ronnythomas/HB-UNI-SenAct-8-8-Hutschiene/README.md

# HB-UNI-SenAct-8-8-Hutschine
## 8x 6A Schaltkontakte + 8 Eingänge 
## Spannungsversorgung 9-36V mit Internen Netzteil oder 5V

## benötigte Hardware
**Vorschlag Bauteile**
* 1x Arduino Pro Mini **ATmega328P (3.3V/8MHz)**
* 1x CC1101 Funkmodul **(868 MHz)**
* 1x FTDI Adapter (wird nur zum Flashen benötigt)

Meine Verwendetet Teile:[Reichelt](https://www.reichelt.de/my/1537601)  

[Hinweise aus HM Forum](https://homematic-forum.de/forum/viewtopic.php?f=76&t=55610&p=671826#p671826)
[Hinweise aus HM Forum](https://homematic-forum.de/forum/viewtopic.php?f=76&t=67728)

[Kontakt via Facebook](https://www.facebook.com/ronny.thomas.83)

[Software](/Sketch)

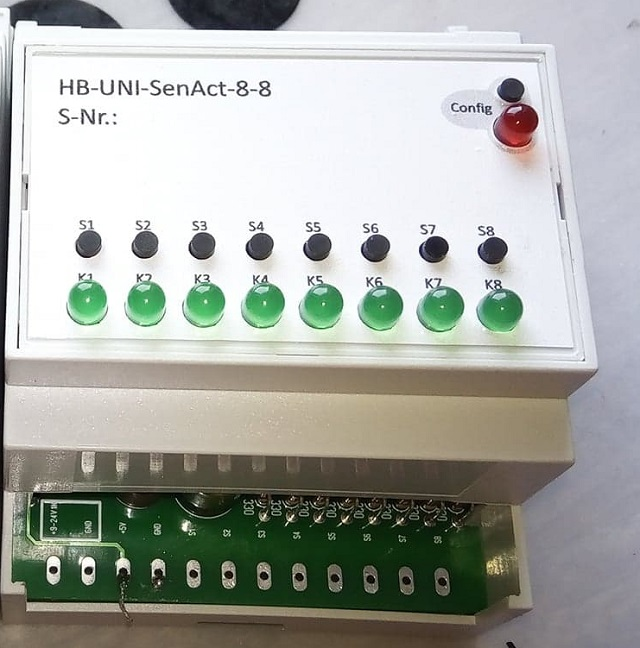
[picture p1: Images/1.jpg]

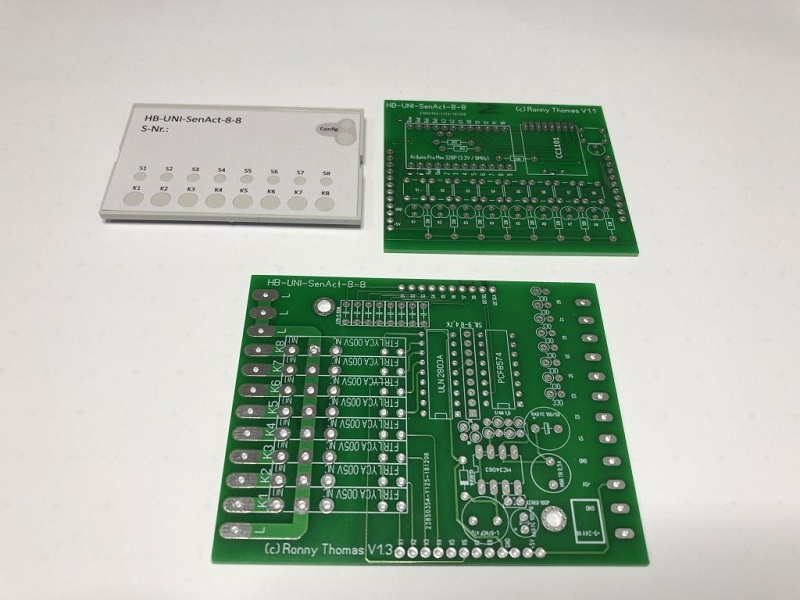
[picture p2: Images/2.JPG]


Controller-Platine:
Auf der oberen Platine zuerst die Widerstände bestücken. Danach die Stiftleisten für die Module einlöten.
Passend dazu die beiden Module einlöten (hierzu können die oberen Stiftleisten ein wenig gekürzt werden)
Dann die Taster einlöten, hierzu sollte man erst bei allen nur ein Pin anlöten und dann komplett ausrichten – es ist wichtig, das alle Taster gerade und in einer Linie fixiert werden !
Genauso verfahren wir mit den 5mm LED’s diese sollten auch erst mit einen Pin angelötet werden und dann ausgerichtet werden.
Die Antenne ist aber nicht zu vergessen, die durch die Platine „gefädelt“ wird und am Empfangsmodul mittig eingelötet wird. Dazu sind passende Bohrungen auf dem Board vorhanden.

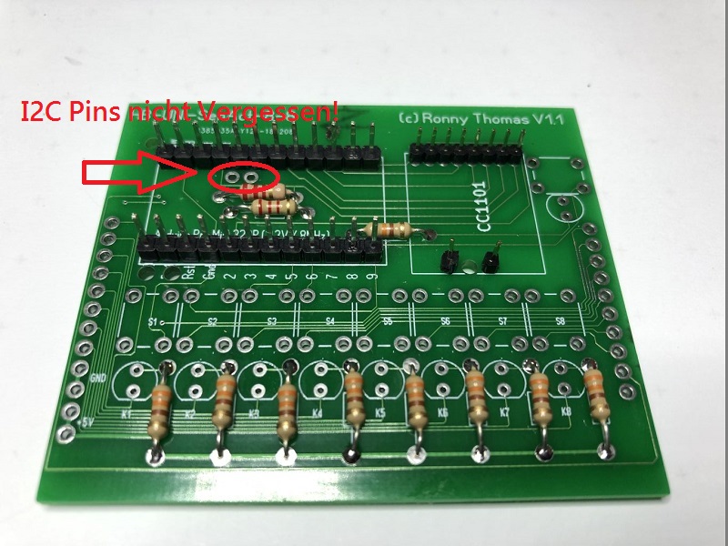
[picture p3: Images/3.JPG]

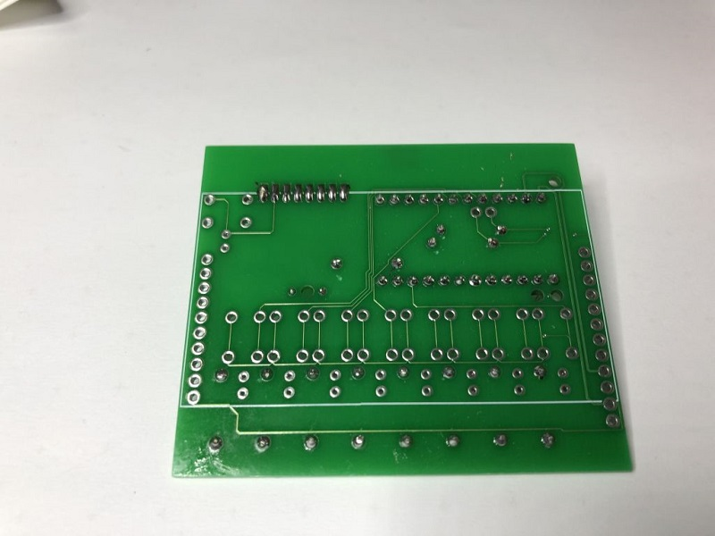
[picture p4: Images/4.JPG]

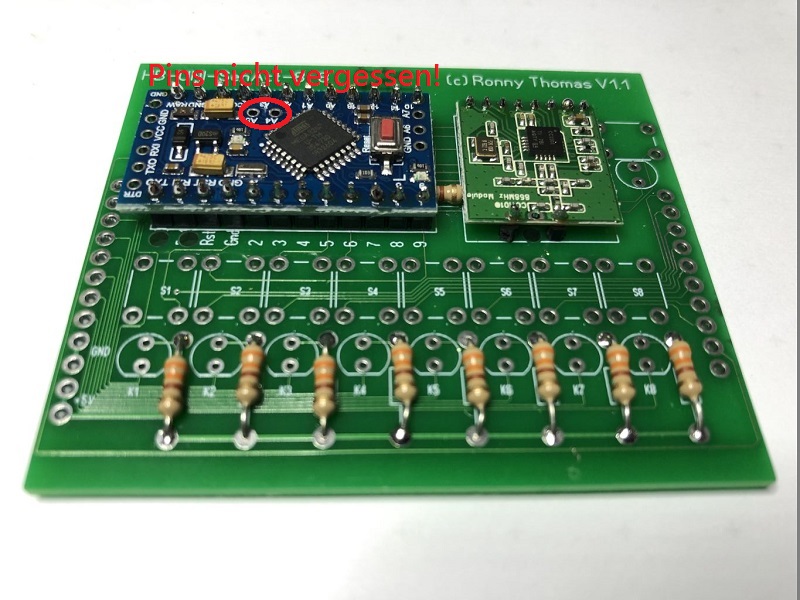
[picture p5: Images/5.JPG]

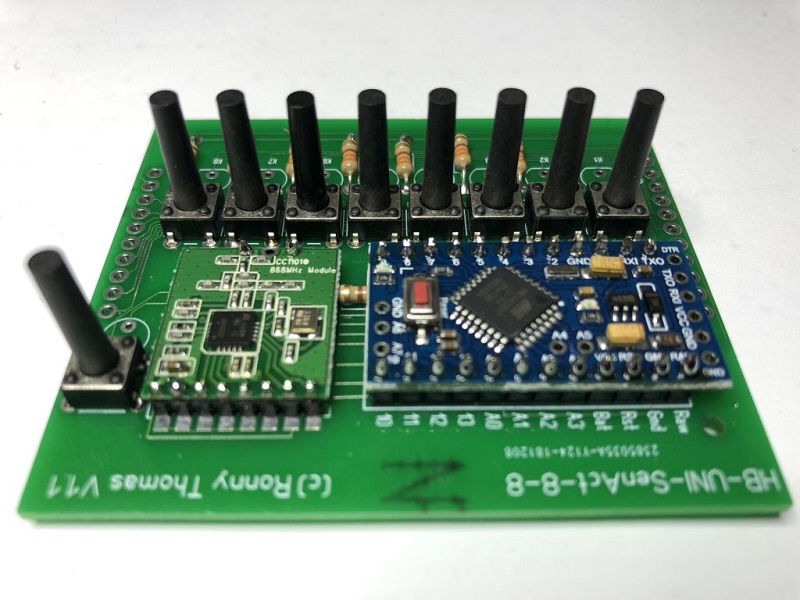
[picture p6: Images/6.JPG]

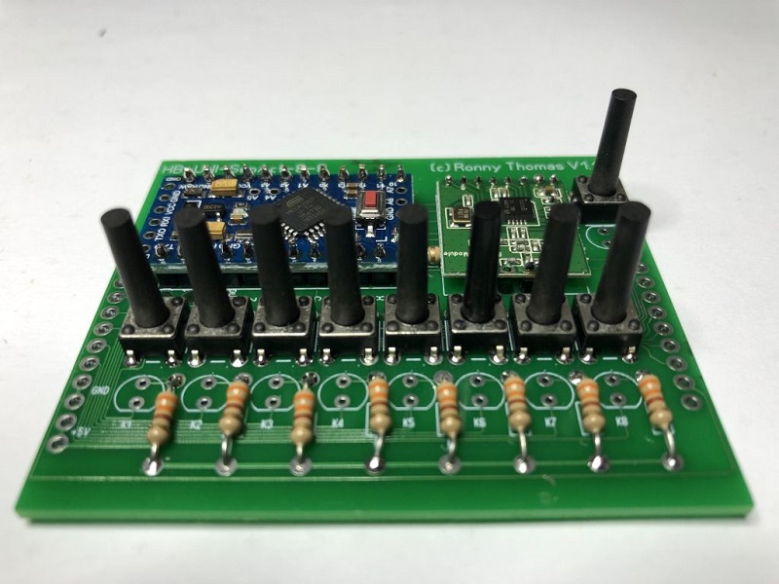
[picture p7: Images/7.JPG]

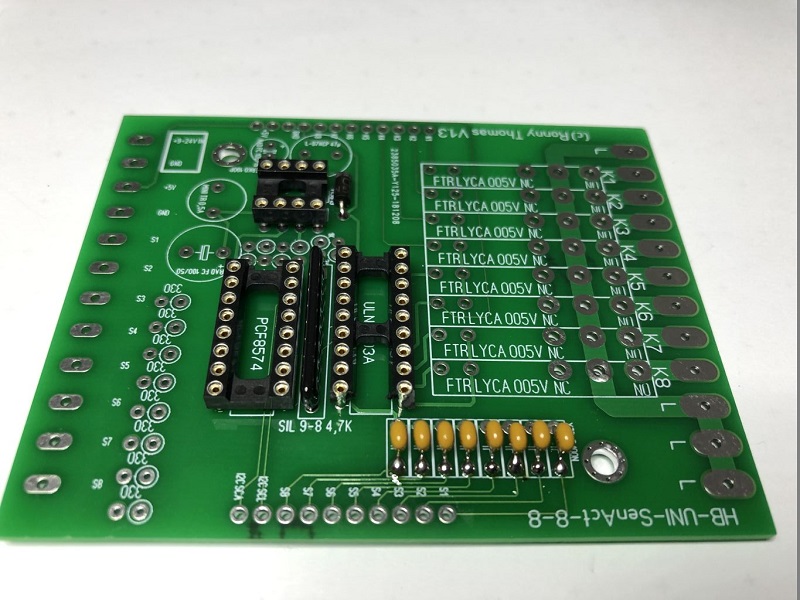
[picture p8: Images/8.JPG]

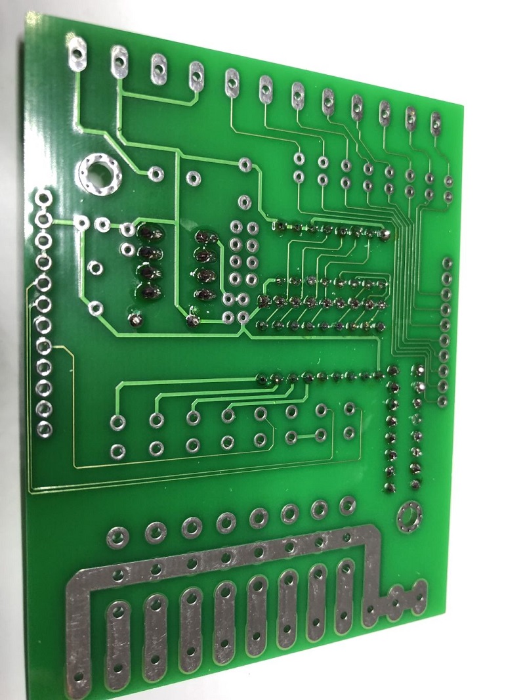
[picture p9: Images/9.JPG]

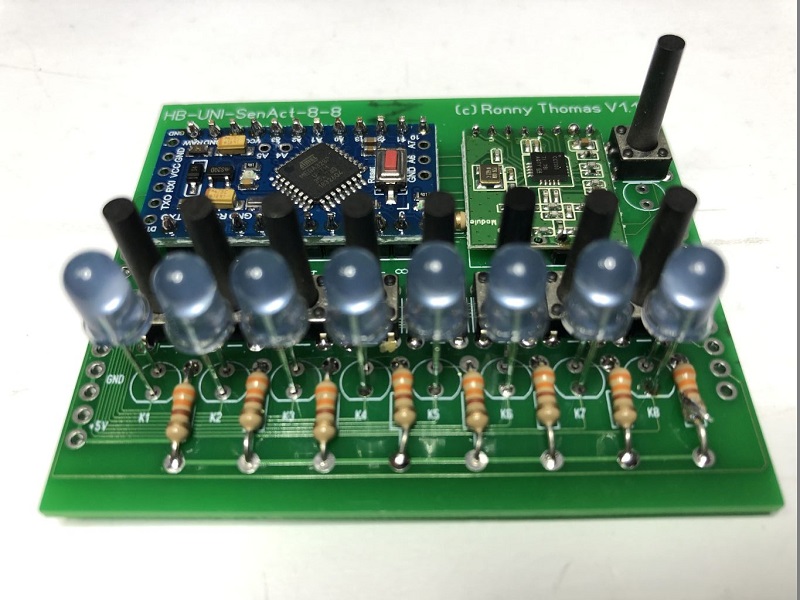
[picture p10: Images/10.JPG]

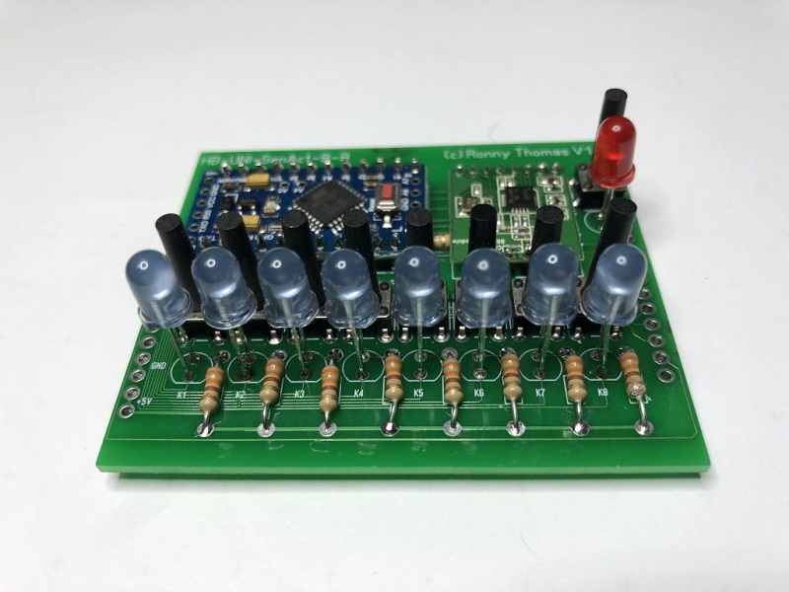
[picture p11: Images/11.JPG]

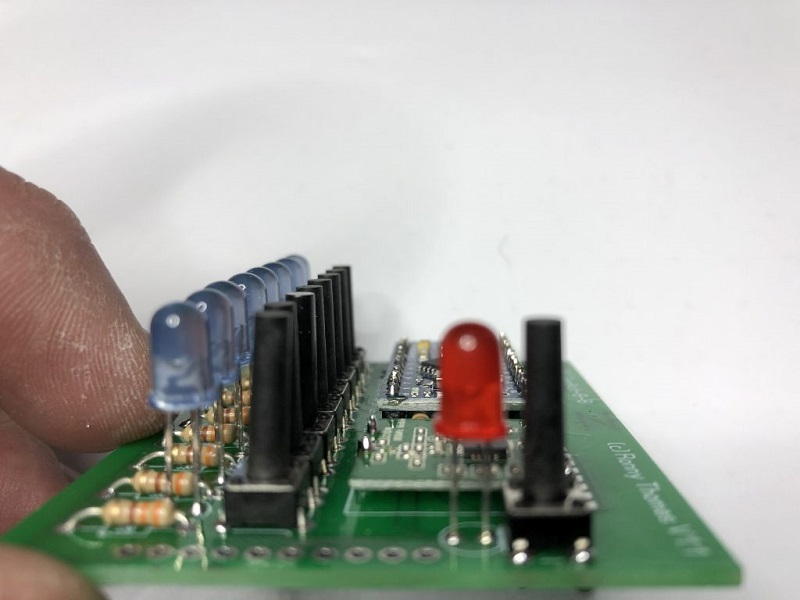
[picture p12: Images/12.JPG]

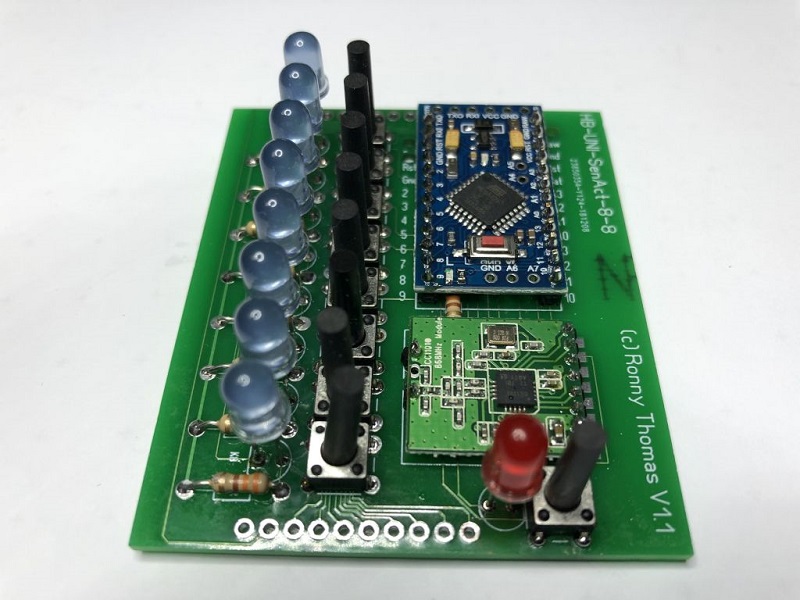
[picture p13: Images/13.JPG]

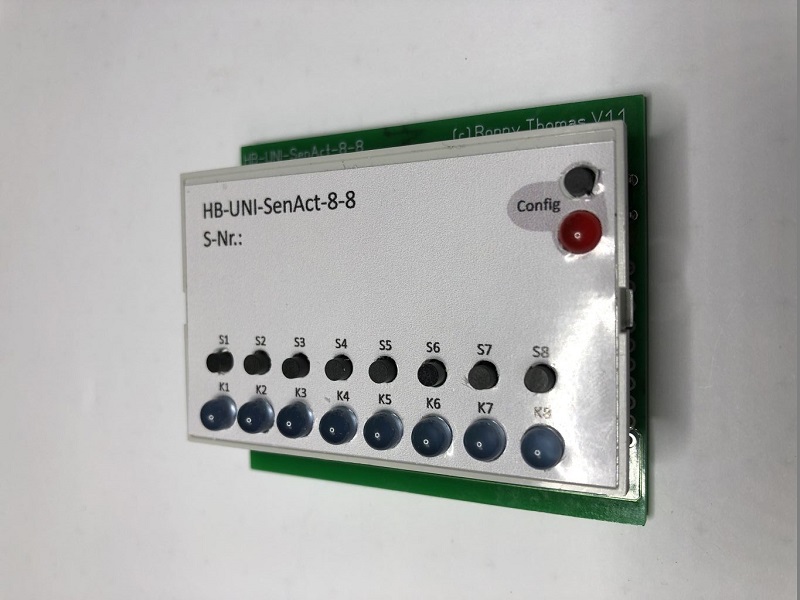
[picture p14: Images/14.JPG]

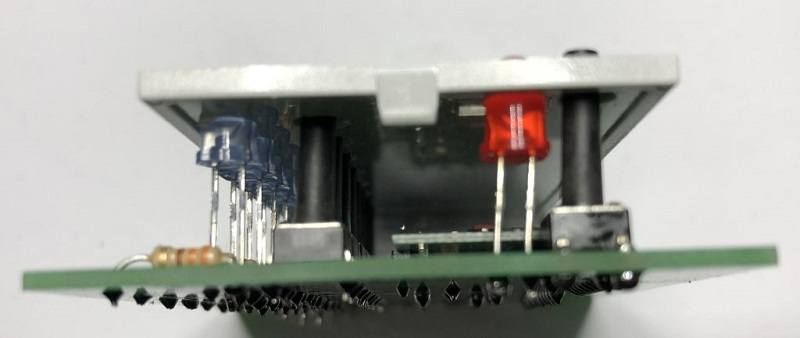
[picture p15: Images/15.JPG]


Hauptplatine:
Die Diode und nach die Sockel für IC’s einlöten (Kann man auch ohne Sockel bestücken)
8x Kondensatoren einlöten dann die stehenden Bauteile (Widerstände ect.)
Immer erst die „kleinsten“ Bauteile zuerst, danach die größeren.
Hier sollte spätestens die Entscheidung fallen, ob ich mit 5V direkt einspeisen oder alternativ über das Schaltnetzteil gehen will.
Wenn dieses nicht genutzt wird, können dafür die Bauteile weggelassen werden.
Die Schraubklemmen (oder alternativ Wago) auflöten und dann die Relais. Die Leiterbahnen zu diesen sollte man noch extra verzinnen (bezüglich Strombelastung)

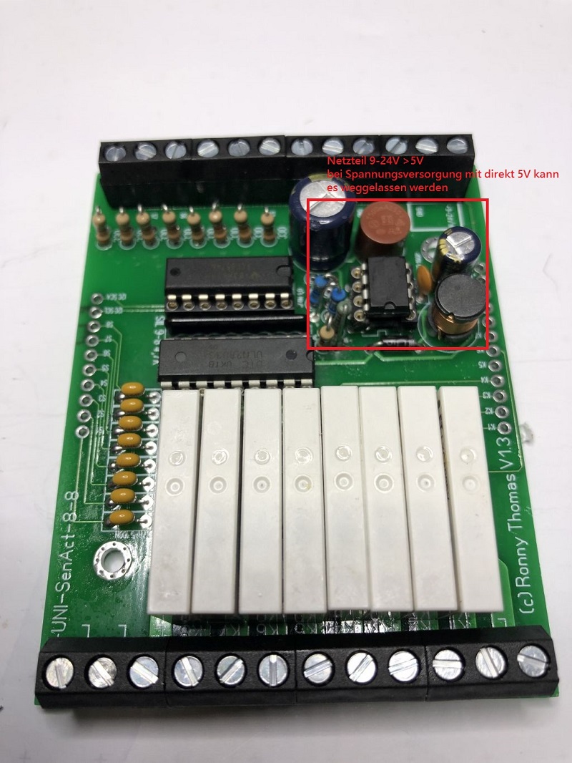
[picture p16: Images/16.JPG]

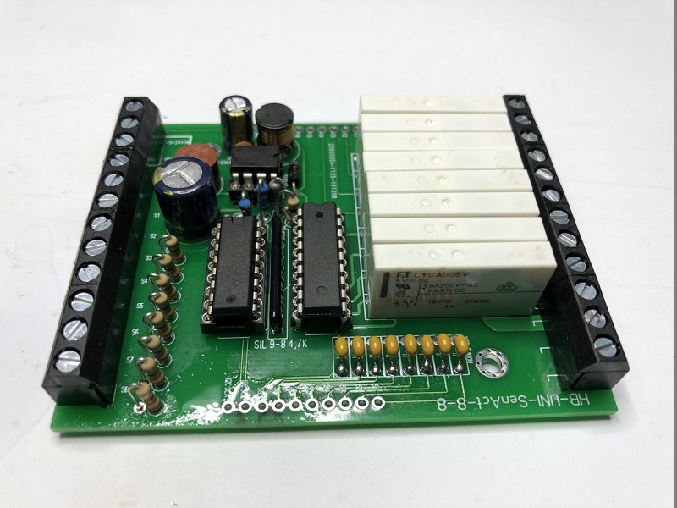
[picture p17: Images/17.JPG]

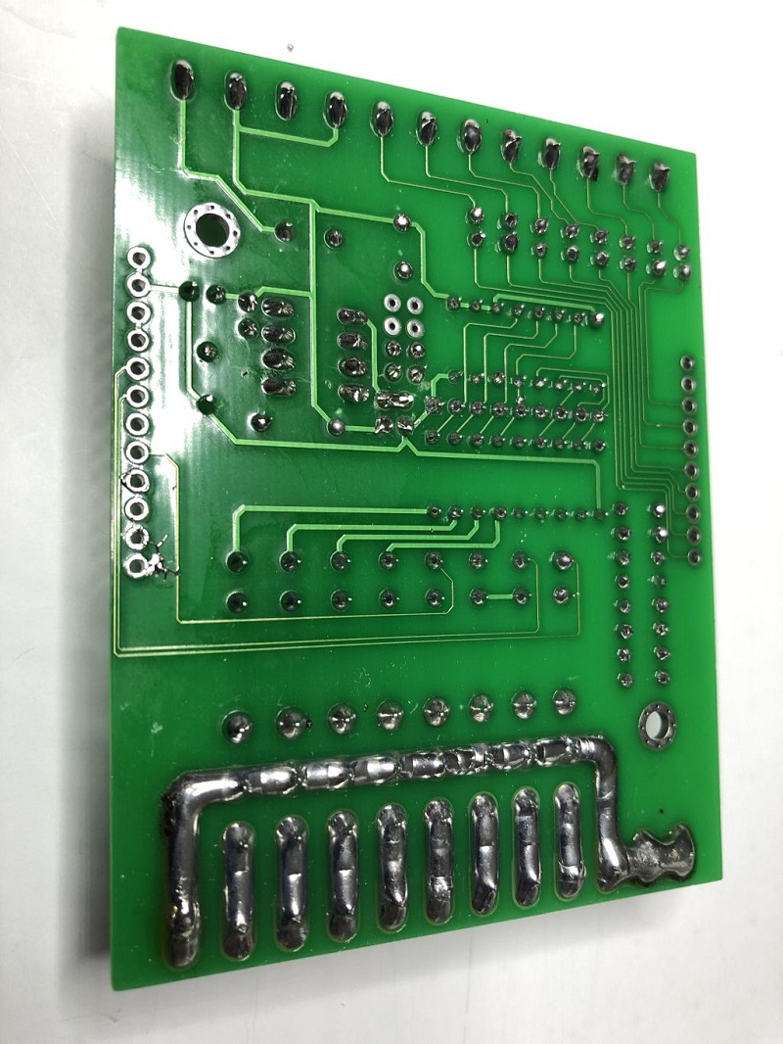
[picture p18: Images/18.JPG]

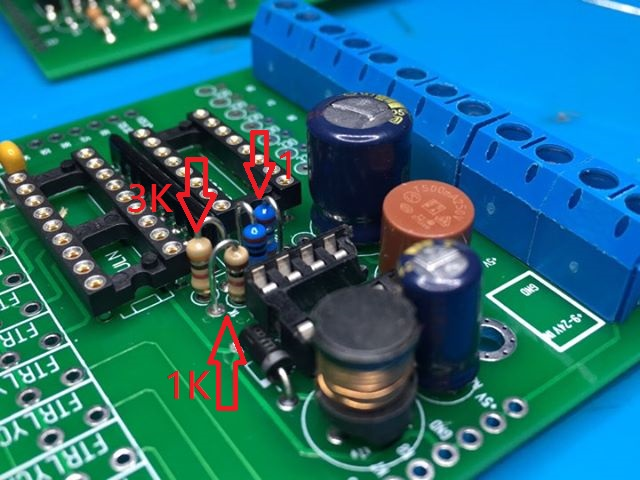
[picture p19: Images/24.jpg]


Jetzt kommen die beiden langen Stiftleisten die jeweils rechts und links auf der Hauptplatine zuerst angelötet werden.
Dann wird die Controllerplatine aufgesetzt und verlötet, hier können auch die Leisten gekürzt werden.
Den Aufkleber für die Frontplatte genau exakt platzieren. Am besten ist es, die Löcher mit einem 1mm HSS Bohrer erstmal mittig!!! vorzubohren. Anschließend kann man für die LEDs ein 5mm sowie für die Taster ein 2,5mm Bohrer vergrößern.

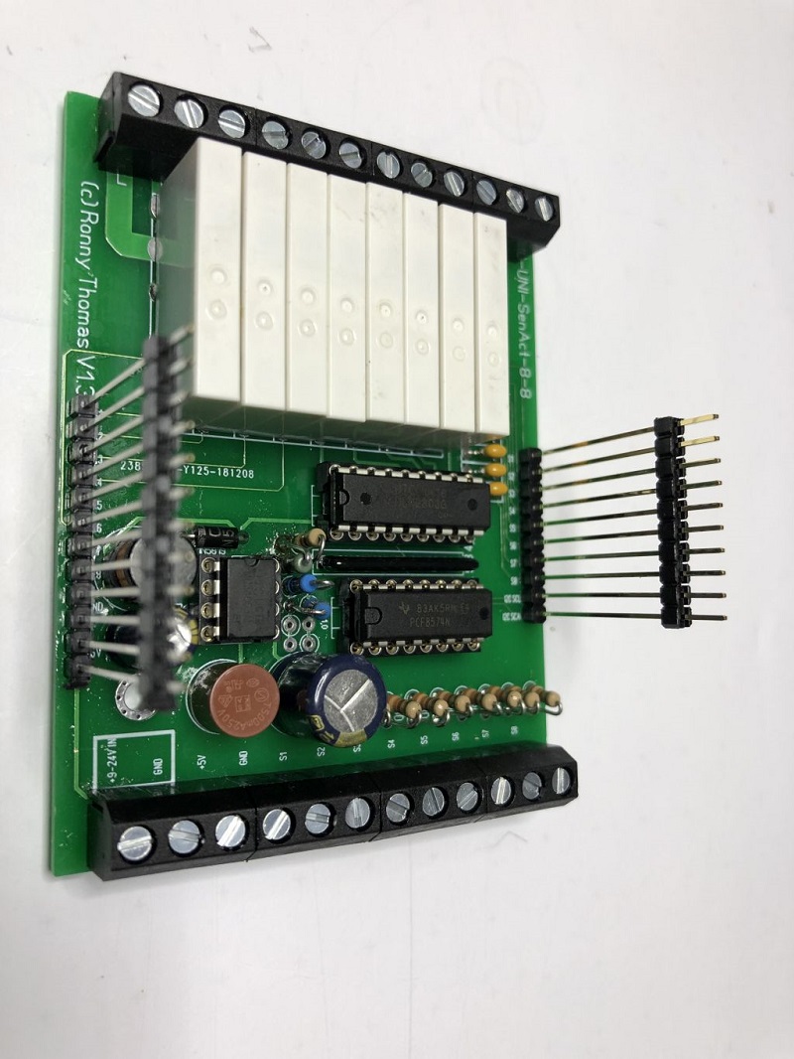
[picture p20: Images/19.JPG]

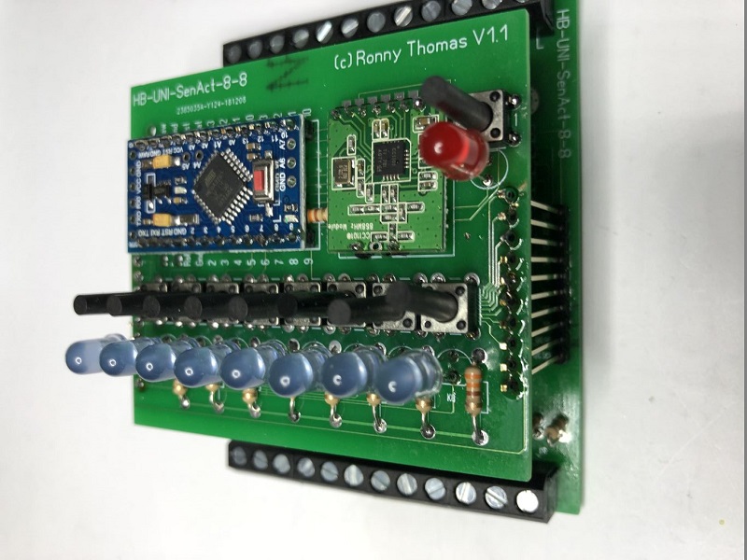
[picture p21: Images/20.JPG]

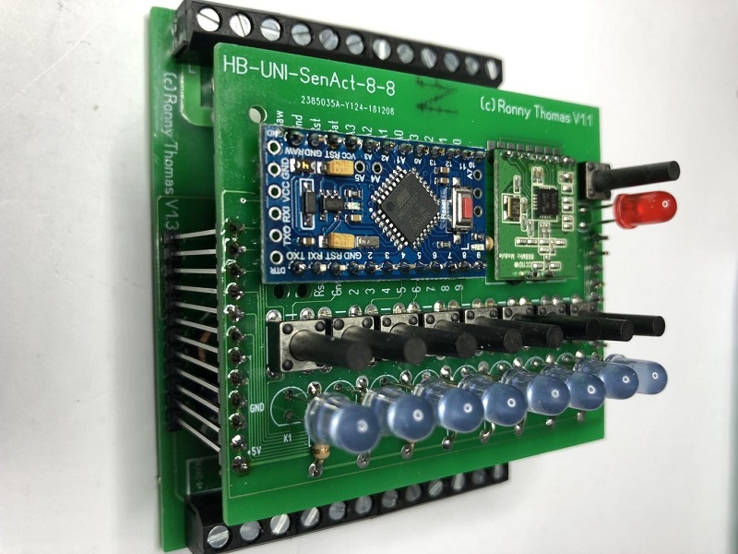
[picture p22: Images/21.JPG]

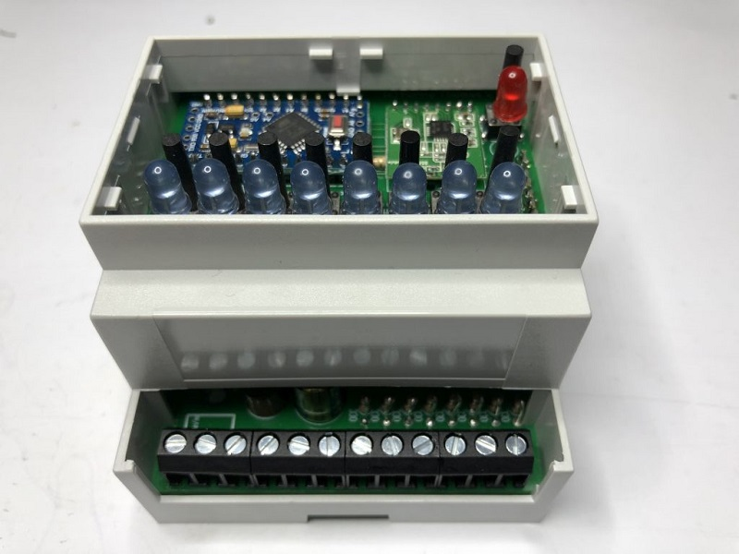
[picture p23: Images/22.JPG]

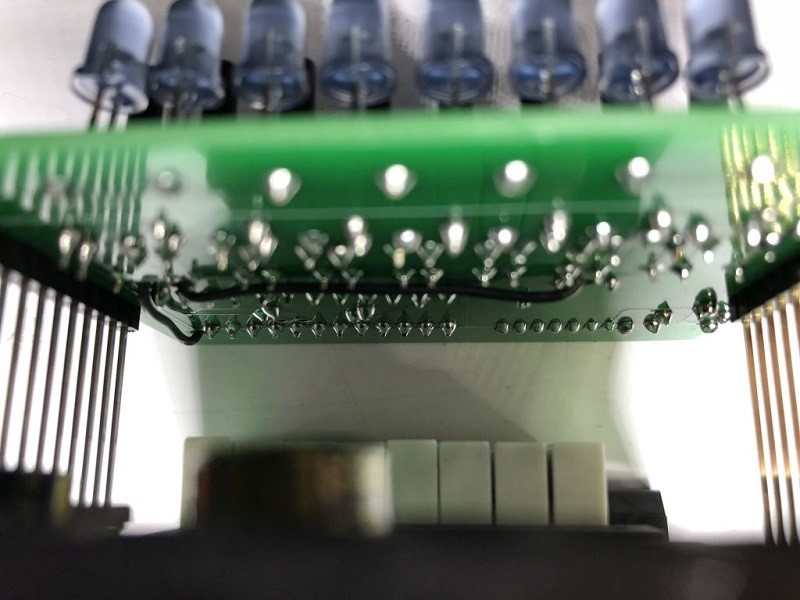
[picture p24: Images/23.JPG]


**Viel Spass bei Bauen**
