ronnythomas/HB-UNI-SenAct-8-8-Hutschiene/(threads)

Thread 1 (2020-09-21):

Platinen kaufen?

Triton-KS, 2020-09-21:
Guten Morgen ronnythomas,

irgendwie habe ich schon oft bei den HM-Produkten gedacht warum beim z.B. HM-MOD-Re-8 nicht auch Ein- und Ausgänge auf eine Platine gebaut werden können. Und das Hutschienen-Modul nicht 8 Kanäle haben kann.
Jetzt bin ich auf dein Projekt aufmerksam geworden, da mein 4Fach-Hutschienen-Modul etwas den Geist auf gibt.

Nun meine Frage Wie wo kann man die Platinen kaufen oder erhält die entsprechenden Dateien.
Kannst du mir hier helfen?

Dankeschön

Closed 2020-10-06.
